Schattental/HBDV3/downloads/RJ45_E5J88-00LJG2-L.stp

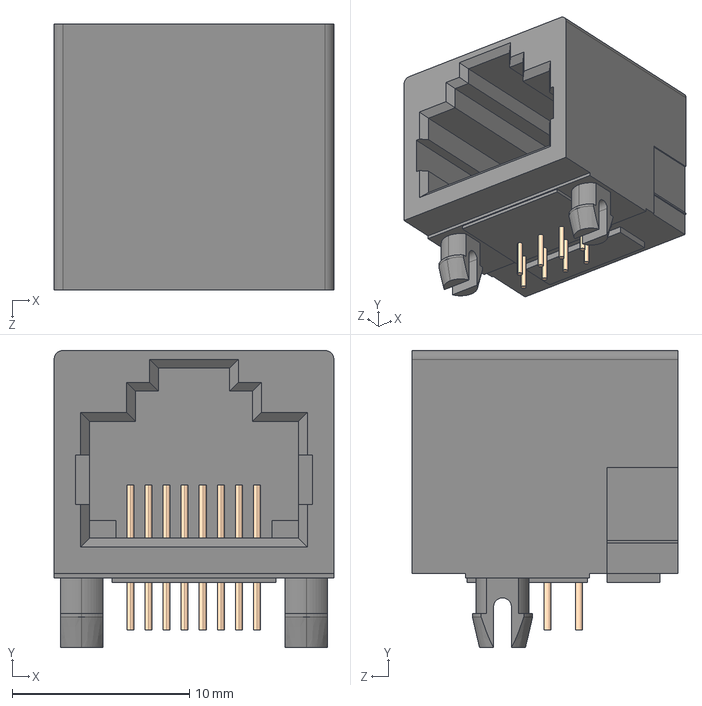
[picture p1: CAD file, 2026-07-01]
downloads/RJ45_E5J88-00LJG2-L.stp
15.8 x 16.8 x 15.0 mm
