Schattental/HBDV3/downloads/RES_LTR100_ROM.step

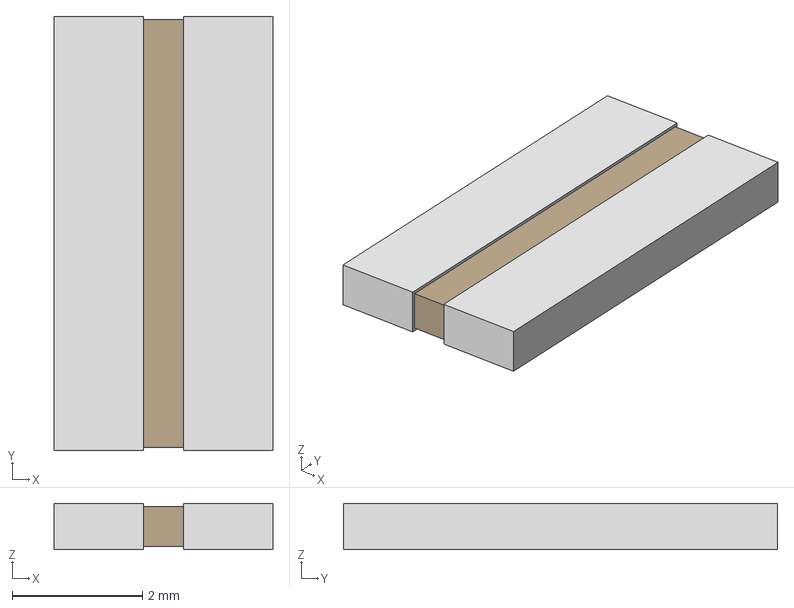
[picture p2: CAD file, 2026-07-01]
downloads/RES_LTR100_ROM.step
3.35 x 6.65 x 0.711 mm
