Schattental/HBDV3/downloads/Würth_100uFcap_radial_6.3mm.stp

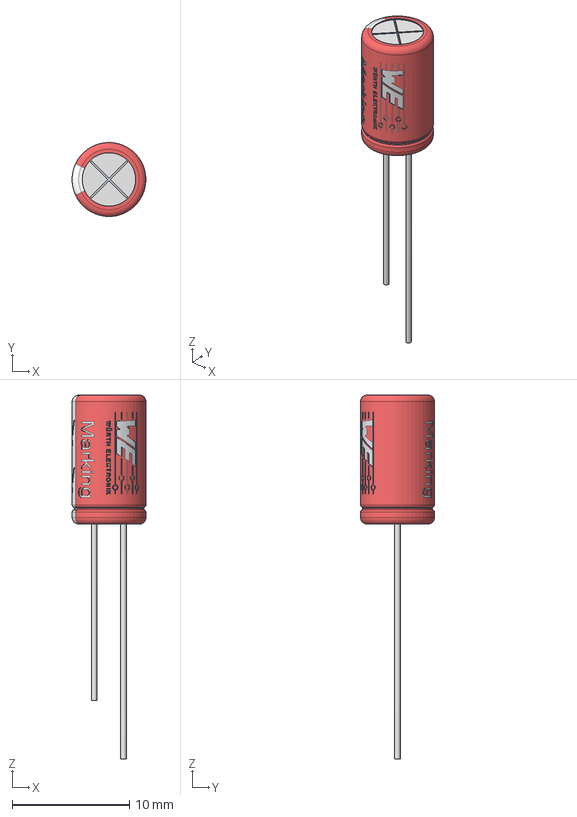
[picture p3: CAD file, 2026-06-30]
downloads/Würth_100uFcap_radial_6.3mm.stp
6.29 x 6.30 x 31.0 mm
