Schattental/HBDV3/downloads/phoenix_push_screwterminal_4p.stp

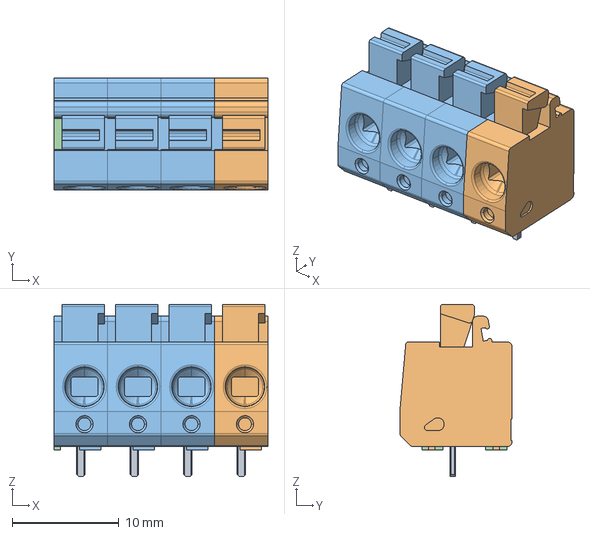
[picture p4: CAD file, 2026-07-01]
downloads/phoenix_push_screwterminal_4p.stp
20.0 x 10.5 x 16.1 mm
