Schattental/HBDV3/plots/HBDV3__Assembly.pdf

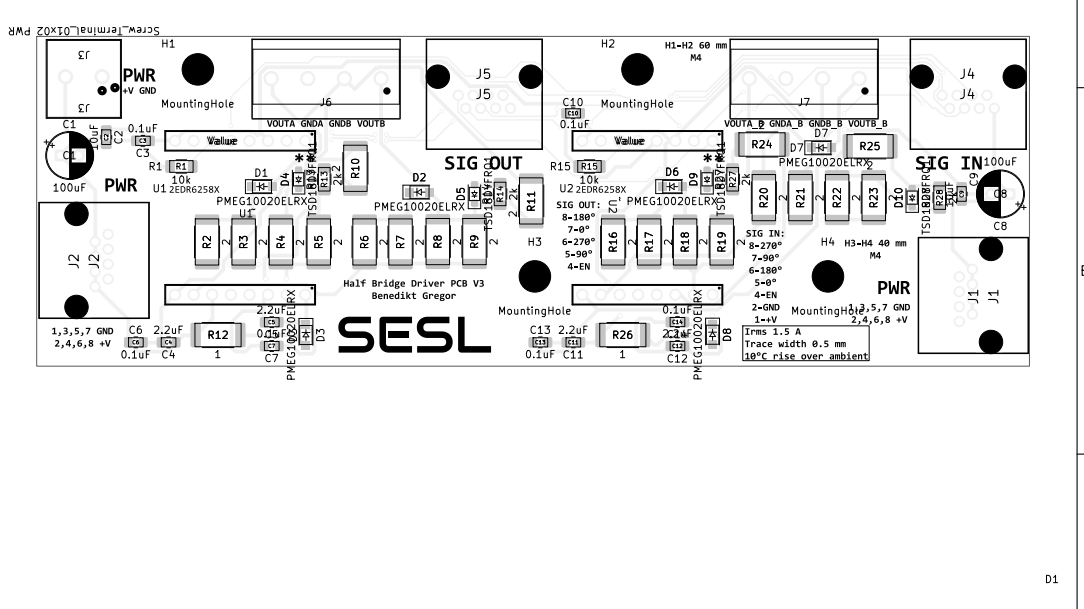
[picture p5: page 1]

Board2Pdf: Black And White TOP - Page 1/2

Sheet: Black And White TOP
File: HBDV3.kicad_pcb
Title:
KiCad E.D.A. 10.0.4

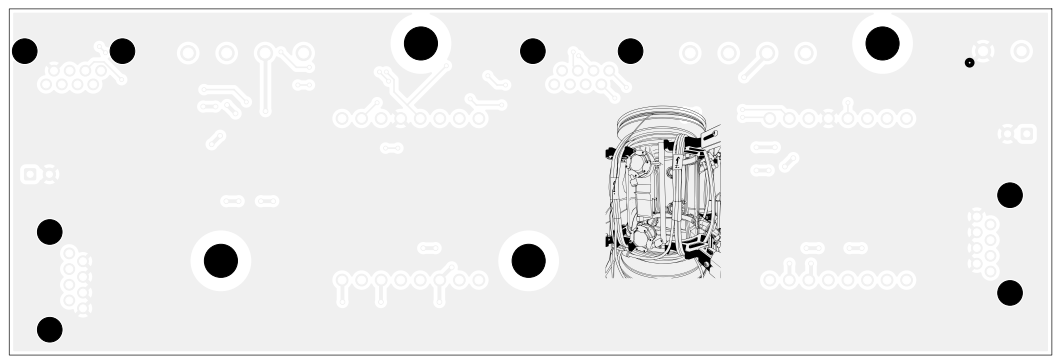
[picture p6: page 2]
D Date:; Size: A4; Rev:

Board2Pdf: Black And White BOT - Page 2/2

Sheet: Black And White BOT
File: HBDV3.kicad_pcb
Title:
KiCad E.D.A. 10.0.4
