Schattental/HBDV3/HBDV3_schematic.pdf

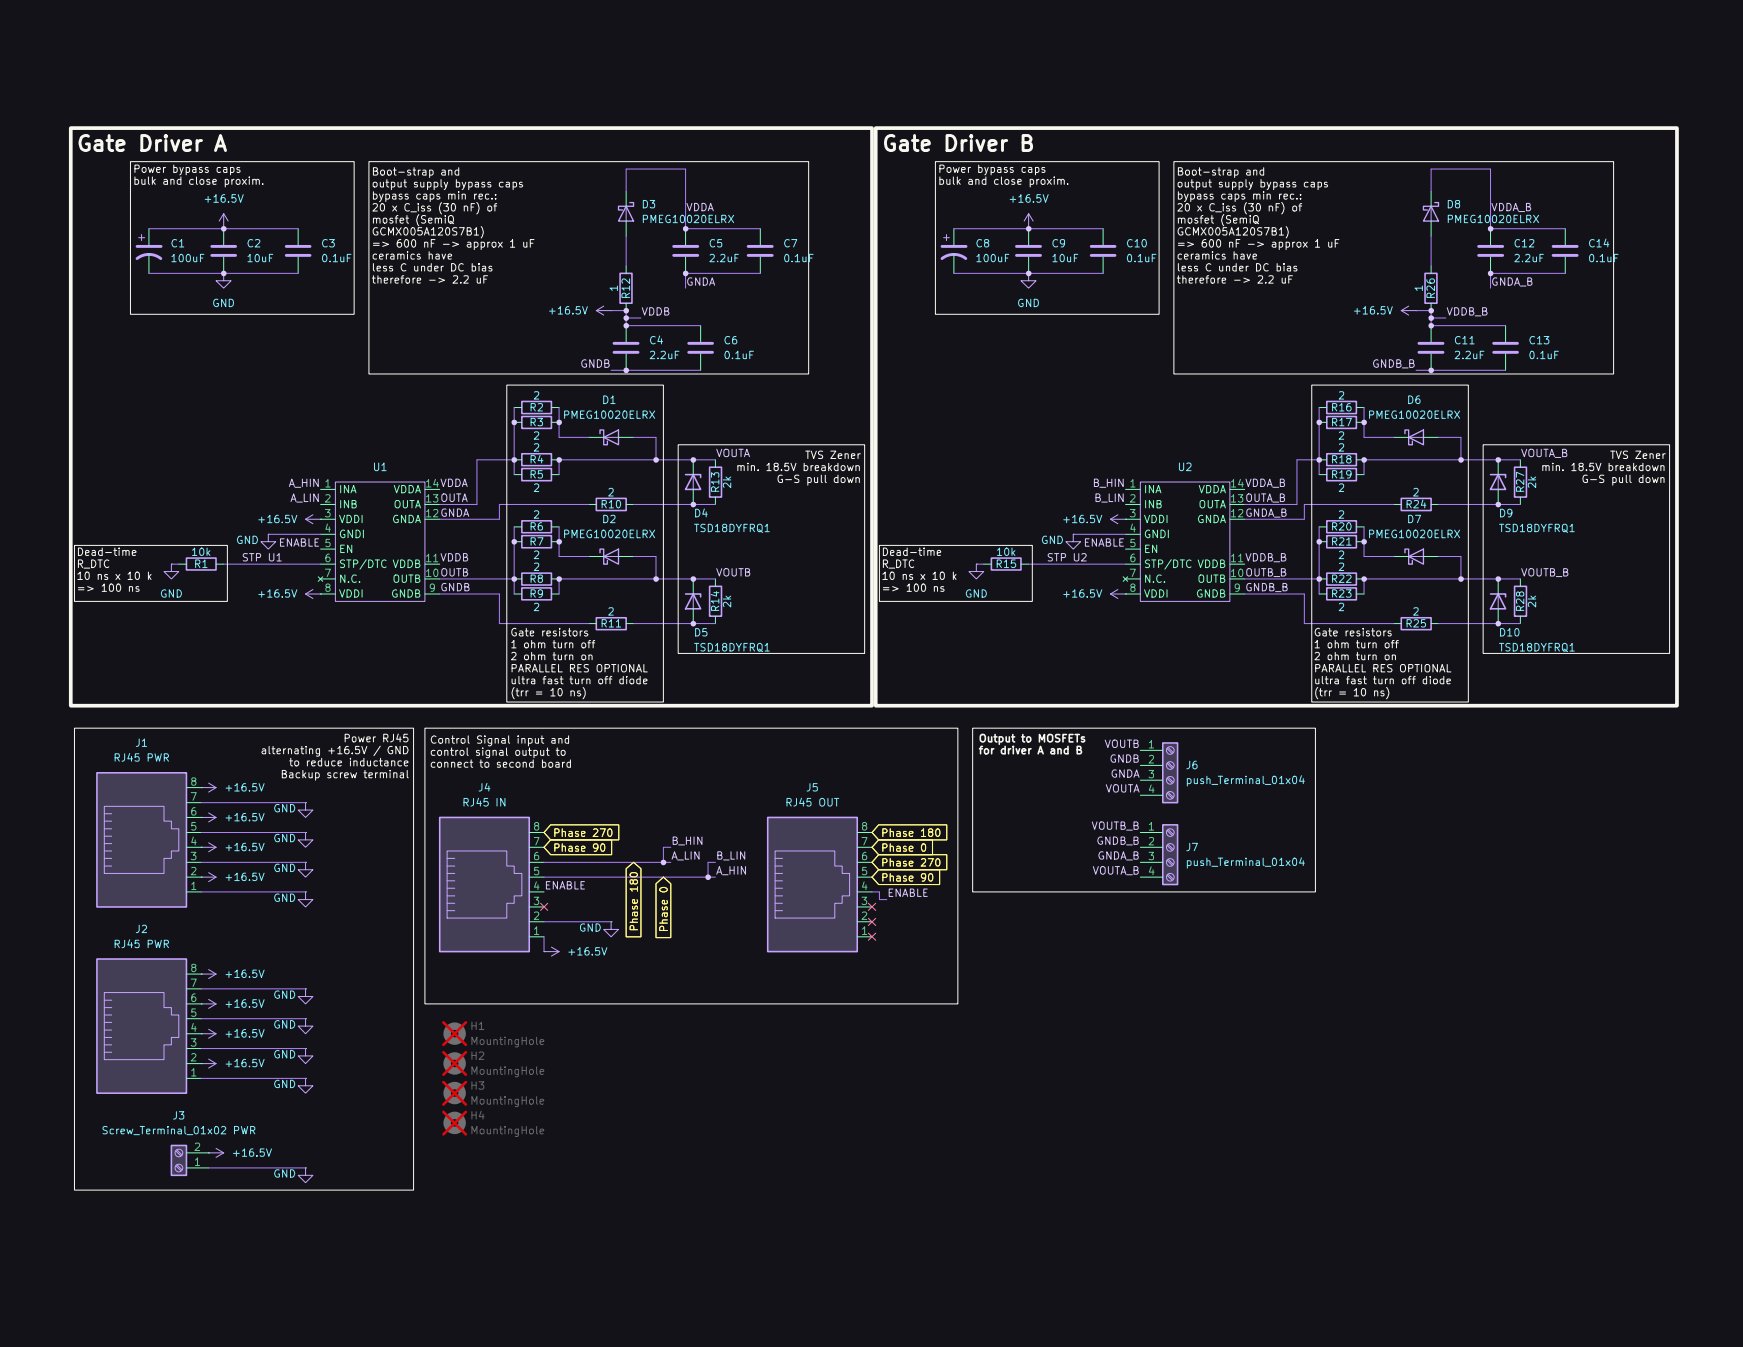
[picture p7: page 1]
