Schattental/HBDV3/HBDV3.kicad_pcb

## KiCad design HBDV3.kicad_pcb (2026-07-16)

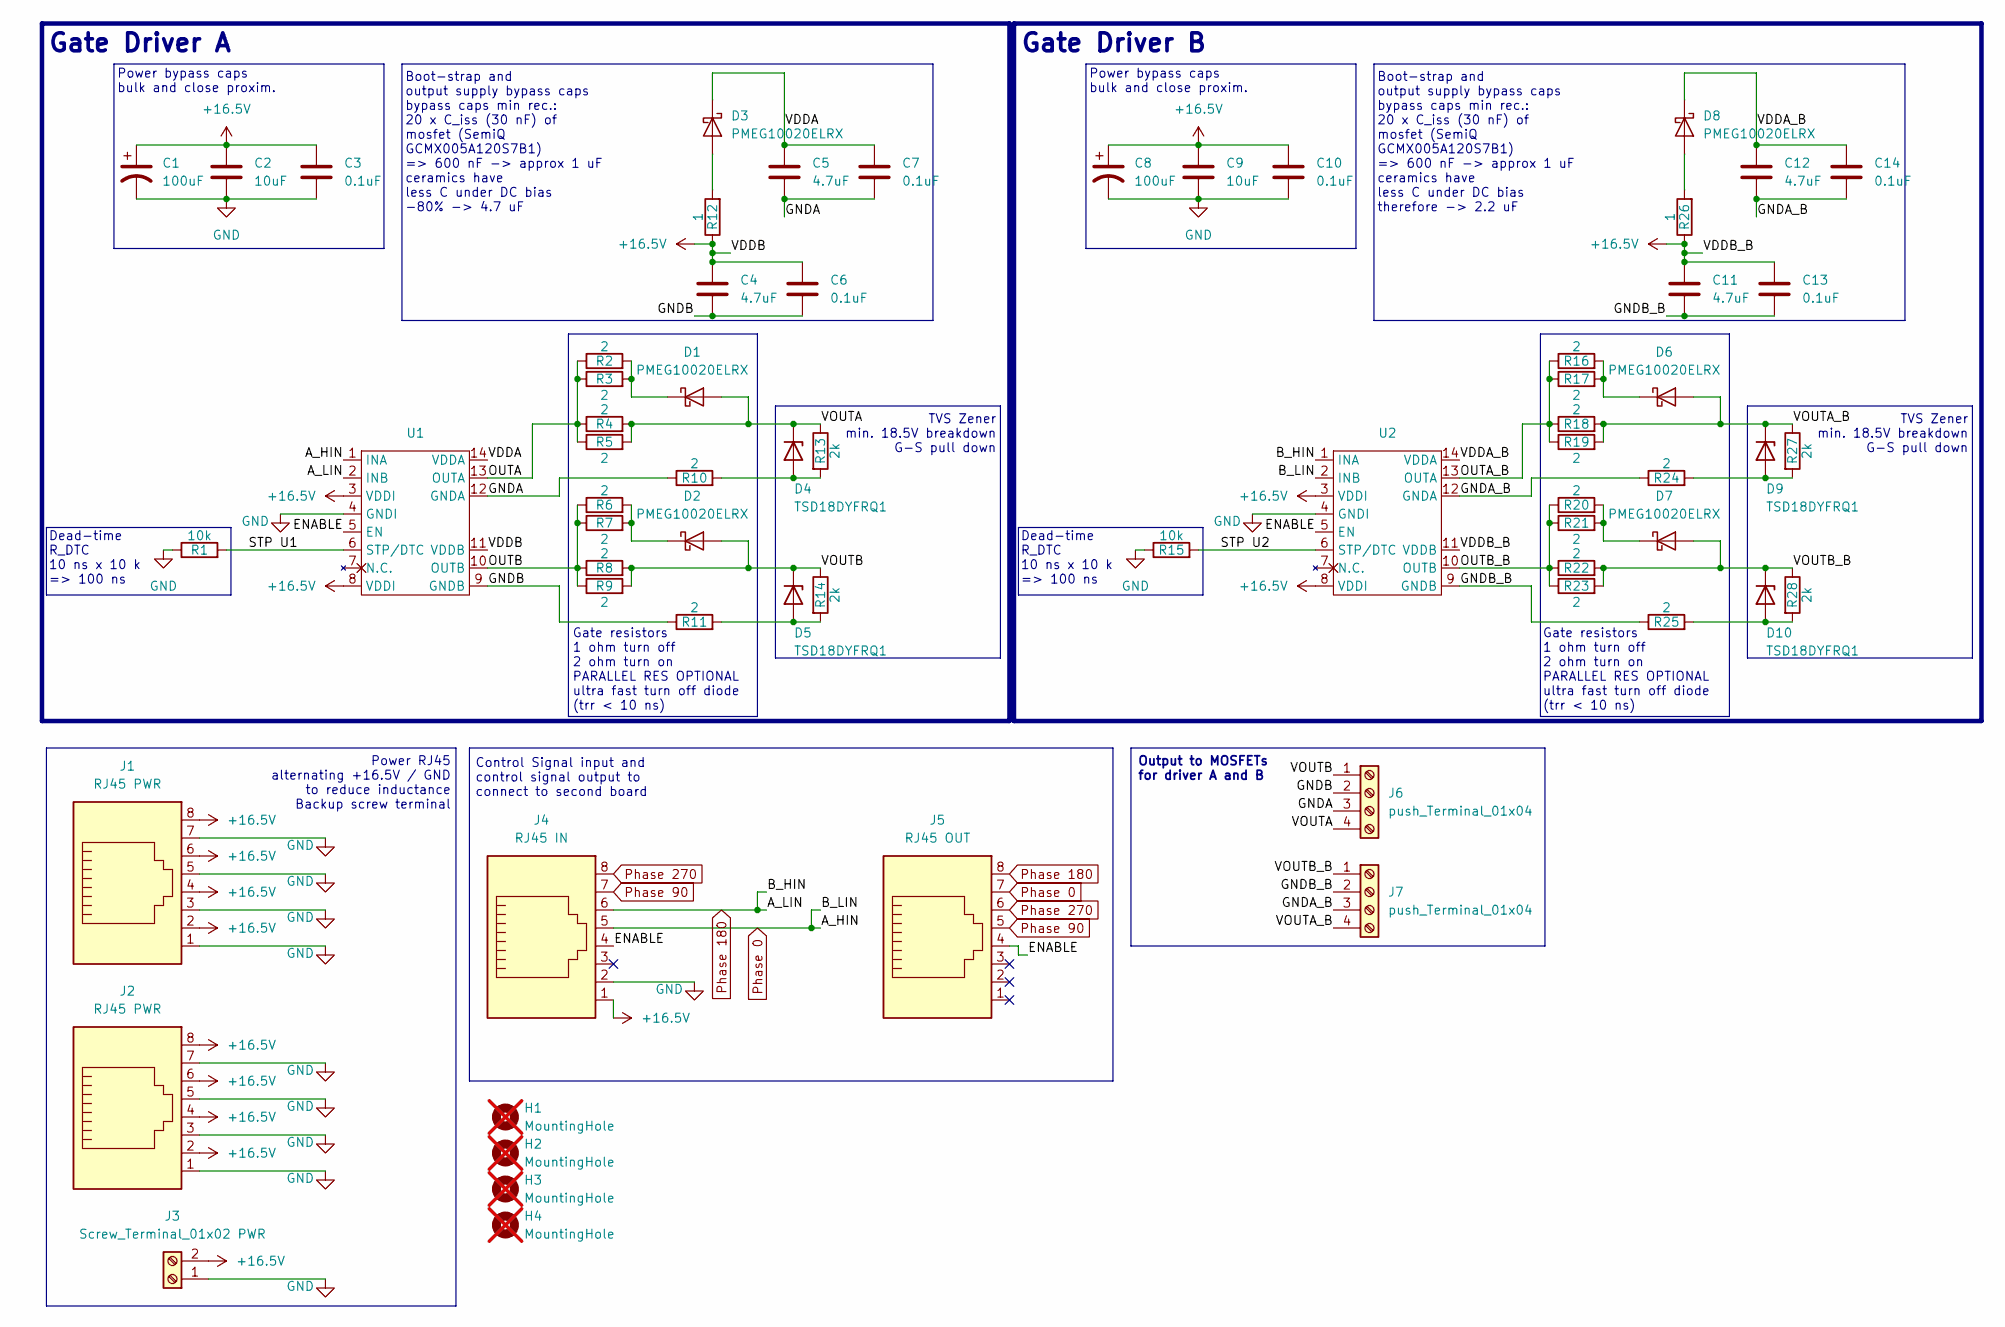
[picture p8: schematic HBDV3.kicad_sch]

Parts:
C1, C8: 100uF; CP_Radial_D6.3mm_H_12.5mm_P2.50mm_Würth
C2, C9: 10uF; C_0805_2012Metric_Pad1.18x1.45mm_HandSolder
C3, C6, C7, C10, C13, C14: 0.1uF; C_0805_2012Metric_Pad1.18x1.45mm_HandSolder
C4, C5, C11, C12: 4.7uF; C_0805_2012Metric_Pad1.18x1.45mm_HandSolder
D1, D2, D3, D6, D7, D8: PMEG10020ELRX; Nexperia_CFP3_SOD-123W
D4, D5, D9, D10: TSD18DYFRQ1; D_SOD-323_HandSoldering
H1, H2, H3, H4: MountingHole; MountingHole_4.3mm_M4_DIN965; not fitted
J1, J2: RJ45 PWR; RJ45_E5J8800LJG2L
J3: Screw_Terminal_01x02 PWR; Phoenix_2p_push_terminal
J4: RJ45 IN; RJ45_E5J8800LJG2L
J5: RJ45 OUT; RJ45_E5J8800LJG2L
J6, J7: push_Terminal_01x04; Phoenix_4p_push_terminal
R1, R15: 10k; R_1206_3216Metric_Pad1.30x1.75mm_HandSolder
R2, R3, R4, R5, R6, R7, R8, R9, R10, R11, R16, R17, R18, R19, R20, R21, R22, R23, R24, R25: 2; R_2512_6332Metric_Pad1.40x3.35mm_HandSolder
R12, R26: 1; R_2512_6332Metric_Pad1.40x3.35mm_HandSolder
R13, R14, R27, R28: 2k; R_1206_3216Metric_Pad1.30x1.75mm_HandSolder
U1, U2: DSO14-300mil-adapter

Connections:
+16.5V: C1.1, C2.1, C3.1, C4.1, C6.1, C8.1, C9.1, C10.1, C11.1, C13.1, J1.2, J1.4, J1.6, J1.8, J2.2, J2.4, J2.6, J2.8, J3.2, J4.1, R12.1, R26.1, U1.3 (VDDI), U1.8 (VDDI), U1.11 (VDDB), U2.3 (VDDI), U2.8 (VDDI), U2.11 (VDDB)
/ENABLE: J4.4, J5.4, U1.5 (EN), U2.5 (EN)
/GNDA: C5.2, C7.2, J6.3, R10.1, U1.12 (GNDA)
/GNDA_B: C12.2, C14.2, J7.3, R24.1, U2.12 (GNDA)
/GNDB: C4.2, C6.2, J6.2, R11.1, U1.9 (GNDB)
/GNDB_B: C11.2, C13.2, J7.2, R25.1, U2.9 (GNDB)
/OUTA: R2.1, R3.1, R4.1, R5.1, U1.13 (OUTA)
/OUTA_B: R16.1, R17.1, R18.1, R19.1, U2.13 (OUTA)
/OUTB: R6.1, R7.1, R8.1, R9.1, U1.10 (OUTB)
/OUTB_B: R20.1, R21.1, R22.1, R23.1, U2.10 (OUTB)
/STP U1: R1.2, U1.6 (STP/DTC)
/STP U2: R15.2, U2.6 (STP/DTC)
/VDDA: C5.1, C7.1, D3.1 (K), U1.14 (VDDA)
/VDDA_B: C12.1, C14.1, D8.1 (K), U2.14 (VDDA)
/VOUTA: D1.2 (A), D4.1 (K), J6.4, R4.2, R5.2, R13.1
/VOUTA_B: D6.2 (A), D9.1 (K), J7.4, R18.2, R19.2, R27.1
/VOUTB: D2.2 (A), D5.1 (K), J6.1, R8.2, R9.2, R14.1
/VOUTB_B: D7.2 (A), D10.1 (K), J7.1, R22.2, R23.2, R28.1
GND: C1.2, C2.2, C3.2, C8.2, C9.2, C10.2, J1.1, J1.3, J1.5, J1.7, J2.1, J2.3, J2.5, J2.7, J3.1, J4.2, R1.1, R15.1, U1.4 (GNDI), U2.4 (GNDI)
unnamed: D1.1 (K), R2.2, R3.2
unnamed: D2.1 (K), R6.2, R7.2
unnamed: D3.2 (A), R12.2
unnamed: D4.2 (A), R10.2, R13.2
unnamed: D5.2 (A), R11.2, R14.2
unnamed: D6.1 (K), R16.2, R17.2
unnamed: D7.1 (K), R20.2, R21.2
unnamed: D8.2 (A), R26.2
unnamed: D9.2 (A), R24.2, R27.2
unnamed: D10.2 (A), R25.2, R28.2
Phase 0: J4.5, J5.7, U1.1 (INA), U2.2 (INB)
Phase 90: J4.7, J5.5
Phase 180: J4.6, J5.8, U1.2 (INB), U2.1 (INA)
Phase 270: J4.8, J5.6

Notes on the sheet:
Power bypass caps bulk and close proxim.
Gate resistors 1 ohm turn off 2 ohm turn on PARALLEL RES OPTIONAL ultra fast turn off diode (trr < 10 ns)
Control Signal input and control signal output to connect to second board
Gate Driver B
Output to MOSFETs for driver A and B
Boot-strap and output supply bypass caps bypass caps min rec.: 20 x C_iss (30 nF) of mosfet (SemiQ GCMX005A120S7B1) => 600 nF -> approx 1 uF ceramics have less C under DC bias therefore -> 2.2 uF
Power RJ45 alternating +16.5V / GND to reduce inductance Backup screw terminal
TVS Zener min. 18.5V breakdown G-S pull down
Dead-time R_DTC 10 ns x 10 k => 100 ns
Boot-strap and output supply bypass caps bypass caps min rec.: 20 x C_iss (30 nF) of mosfet (SemiQ GCMX005A120S7B1) => 600 nF -> approx 1 uF ceramics have less C under DC bias -80% -> 4.7 uF
Gate Driver A

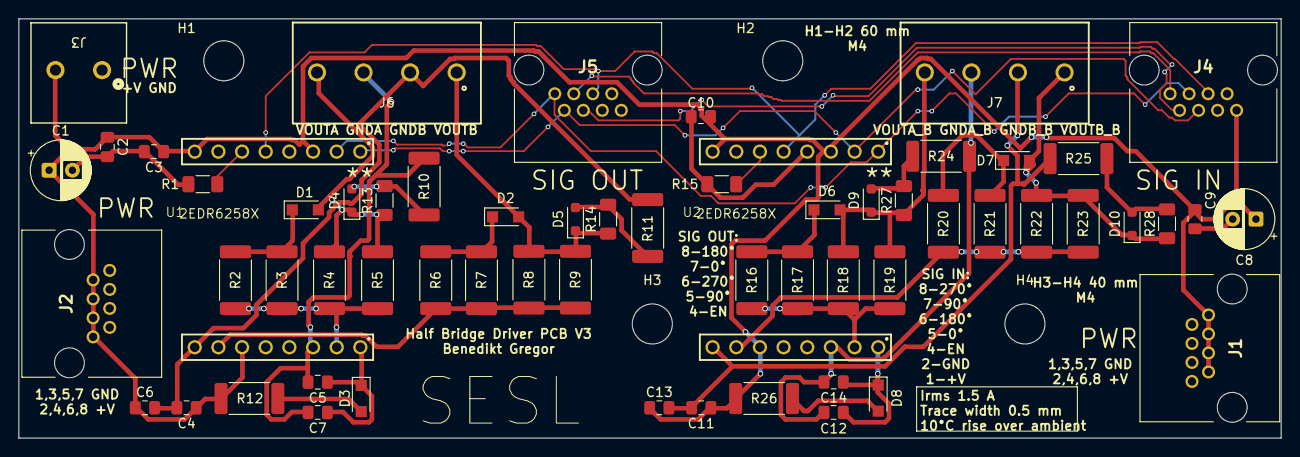
[picture p9: board HBDV3.kicad_pcb from above]

Board: 2 copper layers, 135.5 x 45.0 mm, 65 parts (0 on the bottom side), 33 nets.
