Schattental/HBDV3/(commit log)

2026-06-29 normalize line endings
    [HBDV3.kicad_pcb, HBDV3.kicad_sch]
2026-06-30 big update, half done
    [HBDV3.kicad_pcb, HBDV3.kicad_sch, Würth_100uFcap_radial_6.3mm.stp]
2026-06-30 Full schematic
    [HBDV3.kicad_sch]
2026-07-01 Updated component values
    [HBDV3.kicad_sch]
2026-07-01 Added local stuff
    [1792863.stp, HBDV3.kicad_sch, RES_LTR100_ROM.step, RJ45_E5J88-00LJG2-L.stp, phoenix_push_screwterminal_4p.stp]
2026-07-01 Updated PCB
    [HBDV3.kicad_pcb]
2026-07-02 Changed diode, rough PCB layout
    [HBDV3.kicad_pcb, HBDV3.kicad_sch]
2026-07-02 Finished layout, added silkscreen text, configured track width
    [HBDV3.kicad_pcb, HBDV3.kicad_sch]
2026-07-02 Finished PCB routing
    [HBDV3.kicad_pcb]
2026-07-15 Updated sig in/out for phase splitter compatibility + zener series R
    [HBDV3.kicad_pcb, HBDV3.kicad_sch]
2026-07-16 Gerber files and 4.7uF cap adjustment
    [HBDV3-B_Cu.gbl, HBDV3-B_Mask.gbs, HBDV3-B_Paste.gbp, HBDV3-B_Silkscreen.gbo, HBDV3-Edge_Cuts.gm1, HBDV3-F_Cu.gtl, HBDV3-F_Mask.gts, HBDV3-F_Paste.gtp]
